Andruida/stm32_radio_szakdolgozat/stm32_radio.kicad_pcb

## KiCad design stm32_radio.kicad_pcb (2025-10-06)

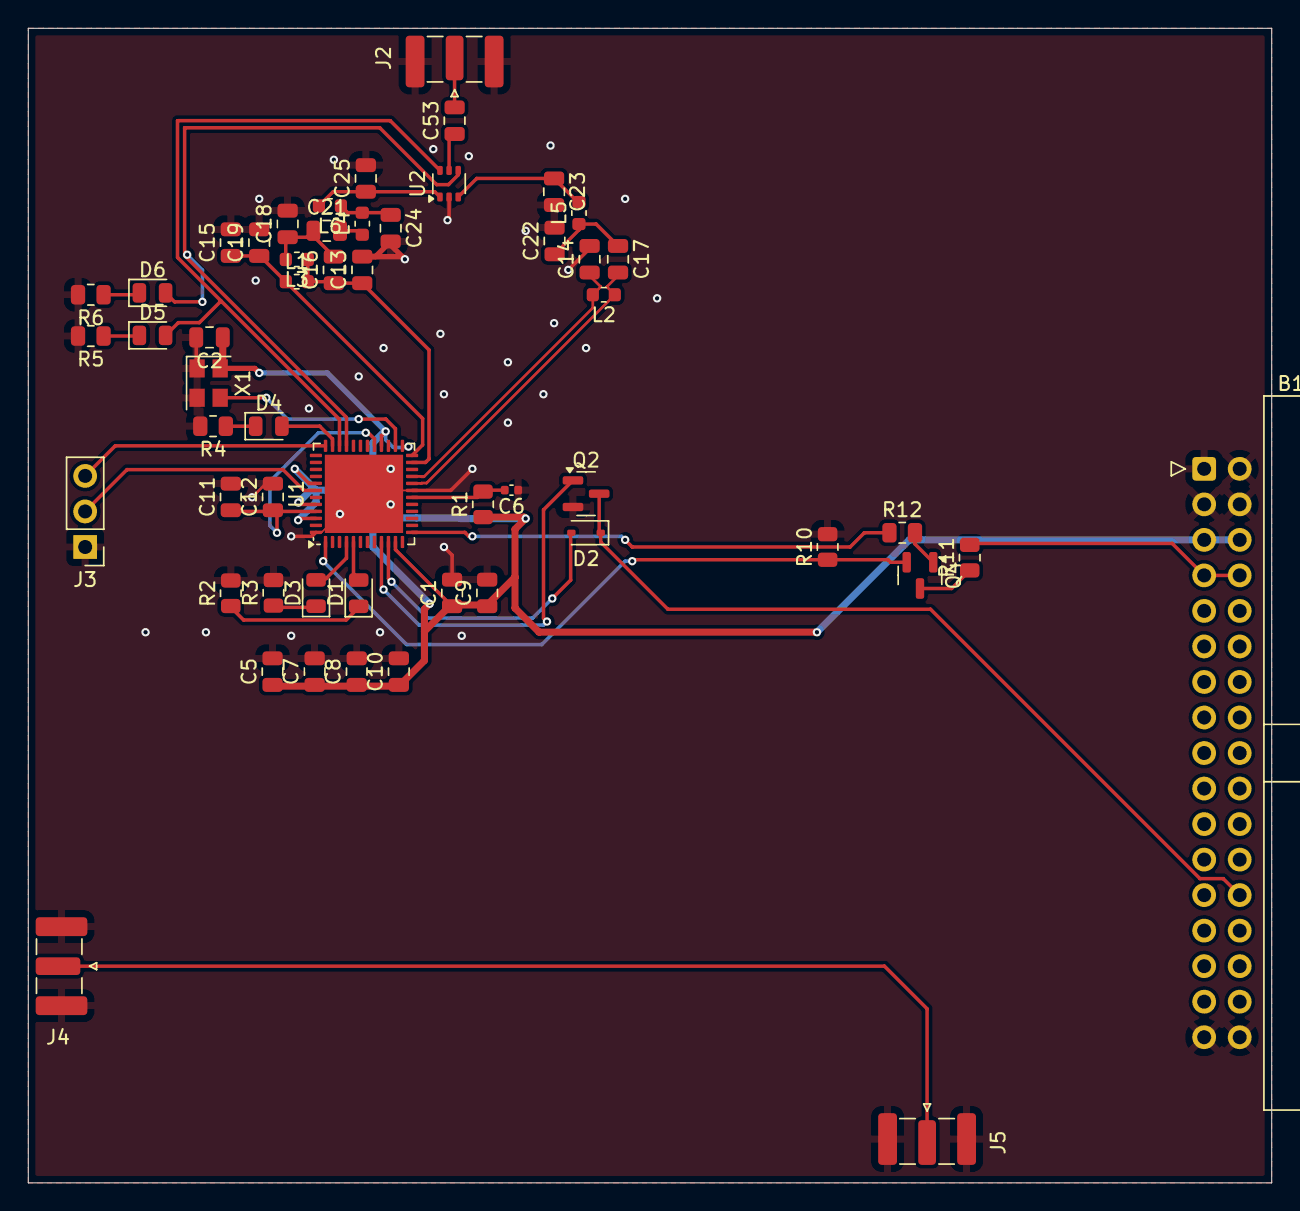
[picture p1: board stm32_radio.kicad_pcb from above]

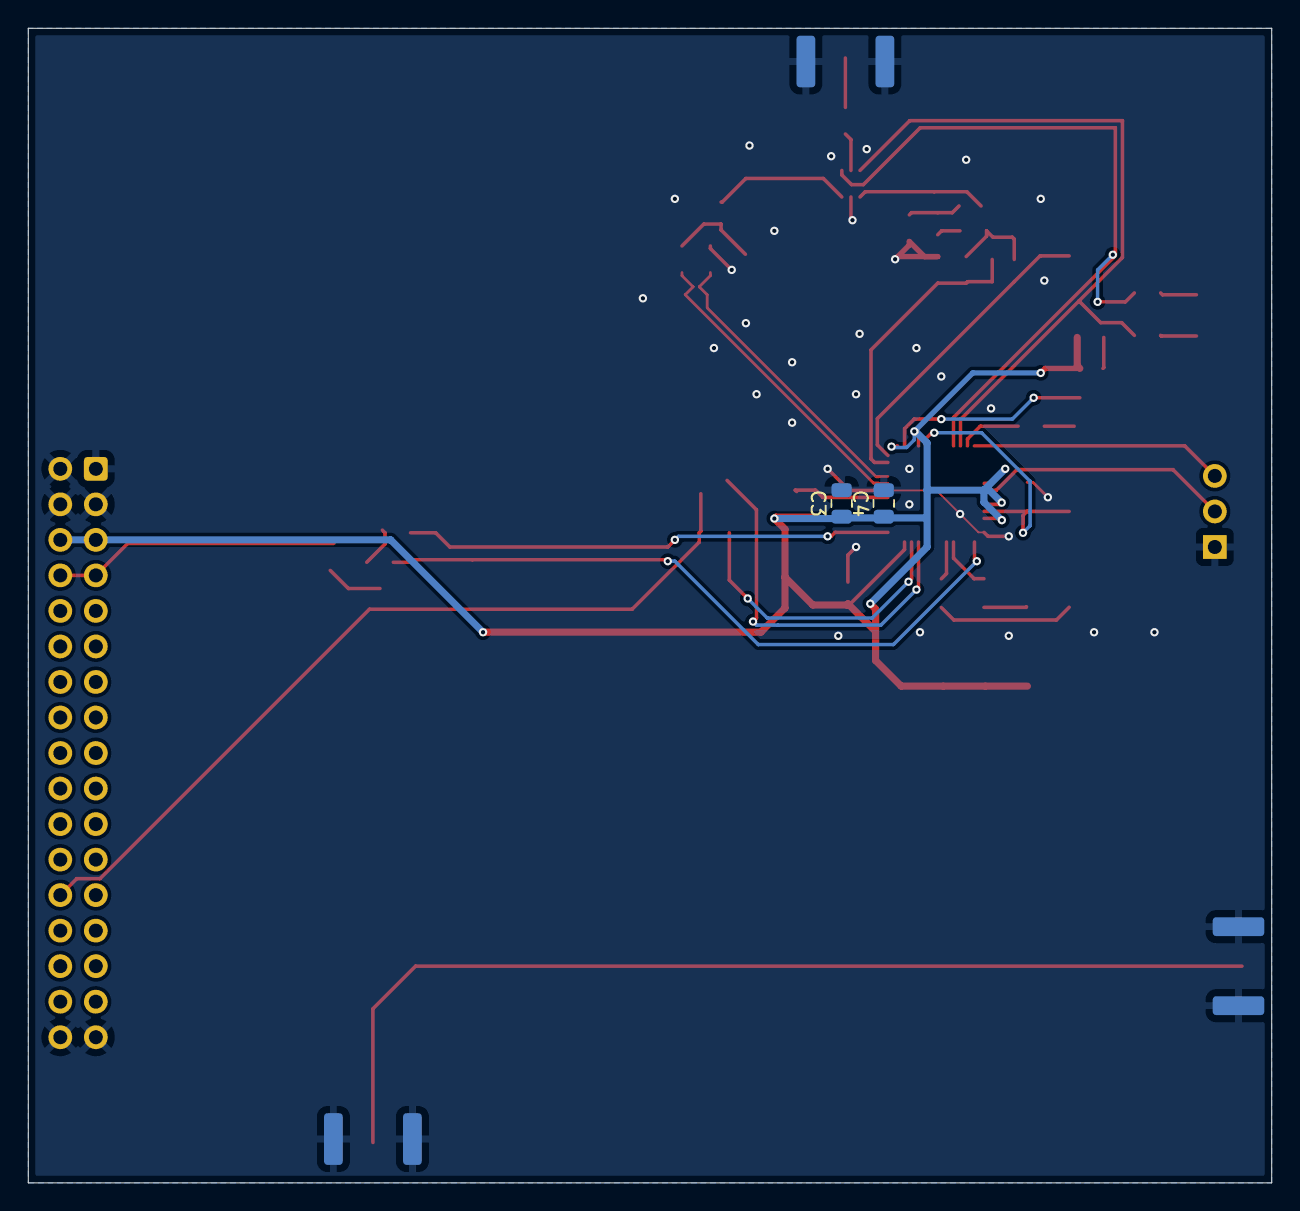
[picture p2: board stm32_radio.kicad_pcb from below]

Board: 2 copper layers, 88.9 x 82.5 mm, 56 parts (2 on the bottom side), 38 nets.

Parts:
B1: IDC-Header_2x17_P2.54mm_Horizontal
C1, C7, C8, C9: 470n; C_0805_2012Metric
C2: 12p; C_0805_2012Metric
C3: 100n; C_0805_2012Metric
C4: 1u; C_0805_2012Metric
C5, C10: 4u7; C_0805_2012Metric
C6: 1n; C_0402_1005Metric
C11, C12: 10n; C_0805_2012Metric
C13: 0p7; C_0805_2012Metric
C14: 4.7pF; C_0805_2012Metric
C15, C21, C53: 68p; C_0805_2012Metric
C16: 2.7p; C_0805_2012Metric
C17: 3.6pF; C_0805_2012Metric
C18: 15p; C_0805_2012Metric
C19: 47n; C_0805_2012Metric
C22, C23: 6.8pF; C_0805_2012Metric
C24: 8p2; C_0805_2012Metric
C25: 3.3p; C_0805_2012Metric
D1, D3, D4, D5, D6: Green; LED_0805_2012Metric
D2: D_Schottky; D_SOD-323
J2, J4, J5: Conn_Coaxial_Small; SMA_Samtec_SMA-J-P-H-ST-EM1_EdgeMount
J3: Conn_01x03_Pin; PinHeader_1x03_P2.54mm_Vertical
L1: 56n; L_0603_1608Metric
L2, L5: 33nH; L_0603_1608Metric
L3: 11n; L_0603_1608Metric
L4: 22n; L_0603_1608Metric
L6: 0; L_0603_1608Metric
Q2: DMN1019USN-7; SOT-23
Q4: Q_NPN; SOT-23
R1, R10: 10k; R_0805_2012Metric
R2, R3, R4, R5, R6: 470; R_0805_2012Metric
R11: 20k; R_0805_2012Metric
R12: 100k; R_0805_2012Metric
U1: STM32WL55CCU7; QFN-48-1EP_7x7mm_P0.5mm_EP5.6x5.6mm
U2: AS179-92LF; SOT-363_SC-70-6
X1: 32MHz; Oscillator_SMD_Abracon_ASE-4Pin_3.2x2.5mm

Connections:
/50_ohm_test: J4.1 (In), J5.1 (In)
/Radio MCU/1V5: C11.1, C12.1, U1.29 (VDDRF1V55), U1.45 (VFBSMPS)
/Radio MCU/3V3: B1.5 (Reg_bus_3v3), B1.6 (Reg_bus_3v3), C1.1, C2.1, C3.1, C4.1, C5.1, C7.1, C8.1, C9.1, C10.1, R1.1, U1.11 (VDD), U1.25 (VDDPA), U1.28 (VDDRF), U1.41 (VDDA), U1.44 (VDD), U1.46 (VDDSMPS), X1.4 (Vdd)
/Radio MCU/RF out: C53.2, J2.1 (In)
/Radio MCU/RF out/50ohm_1: C16.2, C18.1, C21.1, L3.2
/Radio MCU/RF out/50ohm_2: C21.2, L4.1
/Radio MCU/RF out/50ohm_3: C24.1, L4.2, L6.1
/Radio MCU/RF out/50ohm_RX_1: C17.1, C22.1, L5.1
/Radio MCU/RF out/RFI_N: C14.1, L2.2, U1.21 (RFI_N)
/Radio MCU/RF out/RFI_P: C17.2, L2.1, U1.20 (RFI_P)
/Radio MCU/RF out/RFO_HP: C13.1, C16.1, L1.2, L3.1, U1.23 (RFO_HP)
/Radio MCU/RF out/RF_RX: C23.1, L5.2, U2.3 (J2)
/Radio MCU/RF out/RF_TX: C25.1, L6.2, U2.1 (J3)
/Radio MCU/RF out/RF_unfiltered: C53.1, U2.5 (J1)
/Radio MCU/RF out/RX_EN: D5.2 (A), U1.34 (PA11), U2.6 (V2)
/Radio MCU/RF out/TX_EN: D6.2 (A), U1.33 (PA10), U2.4 (V1)
/Radio MCU/RF out/VR_PA: C15.1, C19.1, L1.1, U1.24 (VR_PA)
/Radio MCU/SWCLK: J3.2, U1.42 (PA14)
/Radio MCU/SWDIO: J3.3, U1.36 (PA13)
/Radio MCU/UART: B1.26 (COM_Data), D2.1 (K), Q2.3 (D)
/Radio MCU/UART2_RX: D2.2 (A), U1.10 (PA3)
/Radio MCU/UART2_TX: Q2.1 (G), U1.9 (PA2)
/Radio MCU/VBAT: B1.7 (Unreg_bus), B1.8 (Unreg_bus), R11.2
GND: B1.1 (GND), B1.2 (GND), B1.3 (GND), B1.4 (GND), B1.33 (GND), B1.34 (GND), C1.2, C2.2, C3.2, C4.2, C5.2, C6.1, C7.2, C8.2, C9.2, C10.2, C11.2, C12.2, C13.2, C14.2, C15.2, C18.2, C19.2, C22.2, C23.2, C24.2, C25.2, J2.2 (Ext), J3.1, J4.2 (Ext), J5.2 (Ext), Q2.2 (S), R2.2, R3.2, R4.2, R5.2, R6.2, R10.2, U1.19 (PH3), U1.48 (VSSSMPS), U1.49 (VSS), U2.2 (GND), X1.1 (EN), X1.2 (GND)
unnamed: D1.2 (A), U1.5 (PB7)
unnamed: D1.1 (K), R2.1
unnamed: D3.2 (A), U1.4 (PB6)
unnamed: D3.1 (K), R3.1
unnamed: D4.2 (A), U1.35 (PA12)
unnamed: D4.1 (K), R4.1
unnamed: D5.1 (K), R5.1
unnamed: D6.1 (K), R6.1
unnamed: Q4.1 (B), R12.2
unnamed: Q4.3 (C), R11.1
unnamed: Q4.2 (E), R10.1, U1.1 (PB3)
unnamed: C6.2, R1.2, U1.18 (NRST)
unnamed: U1.26 (OSC_IN), X1.3 (OUT)
unnamed: R12.1, U1.13 (PA5)
