Andruida/stm32_radio_szakdolgozat/(threads)

Thread 3 (2025-10-02):

LSW NMOS FET issue

kissadamfkut, 2025-10-02:
The Q4 FET is a simulation model with no part number. Impossible to match the pinout to the ordered model.

Closed 2025-10-06.

Thread 4 (2025-10-02):

Random symbol descriptions on page

kissadamfkut, 2025-10-02:
On many symbols, the description field appears. For eg. LSW LED shows the "Light Emitting Diode" text, covering the branch of the circuit.

Thread 7 (2025-10-02):

TX --> RX coupling

kissadamfkut, 2025-10-02:
Too tight unnecesarly, should be put more away:

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

Thread 8 (2025-10-02):

Q1 footprint too large

kissadamfkut, 2025-10-02:
sot23?

Thread 9 (2025-10-02):

D2 footprint too large

kissadamfkut, 2025-10-02:
BAT54j?

Closed 2025-10-06.
