Andruida/stm32_radio_szakdolgozat/(commit log)

2025-10-06 Almost ready for production
    [RF_out.kicad_sch, lsw.kicad_sch, stm32_radio.kicad_pcb, stm32_radio.kicad_sch]
2025-10-06 Fix footprints
    [RF_out.kicad_sch, stm32_radio.kicad_pcb]
2025-10-06 Finalize design
    [RF_out.kicad_sch, radio_mcu.kicad_sch, stm32_radio.csv, stm32_radio.kicad_pcb, stm32_radio.kicad_sch]
2025-10-06 Fabrication files
    [pos-top.xlsx, stm32_radio-B_Cu.gbr, stm32_radio-B_Mask.gbr, stm32_radio-B_Paste.gbr, stm32_radio-Edge_Cuts.gbr, stm32_radio-F_Cu.gbr, stm32_radio-F_Mask.gbr, stm32_radio-F_Paste.gbr]
2025-10-06 Altered LCSC part numbers according to current stock
    [radio_mcu.kicad_sch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]
2025-10-06 Changed crystal to oscillator
    [radio_mcu.kicad_sch, stm32_radio.csv]
2025-10-06 Added a pair of SMA connectors for measurement
    [stm32_radio-B_Cu.gbr, stm32_radio-B_Mask.gbr, stm32_radio-B_Paste.gbr, stm32_radio-Edge_Cuts.gbr, stm32_radio-F_Cu.gbr, stm32_radio-F_Mask.gbr, stm32_radio-F_Paste.gbr, stm32_radio-NPTH.drl]
